ikatkov/metal-detector/fet-n-coil-test/thermal.jpg

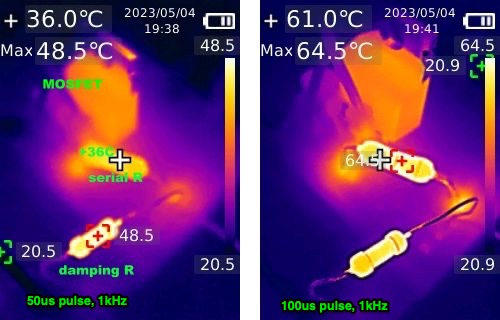
fet-n-coil-test/thermal.jpg
