ikatkov/metal-detector/2023-06-30/noise-canceling.jpg

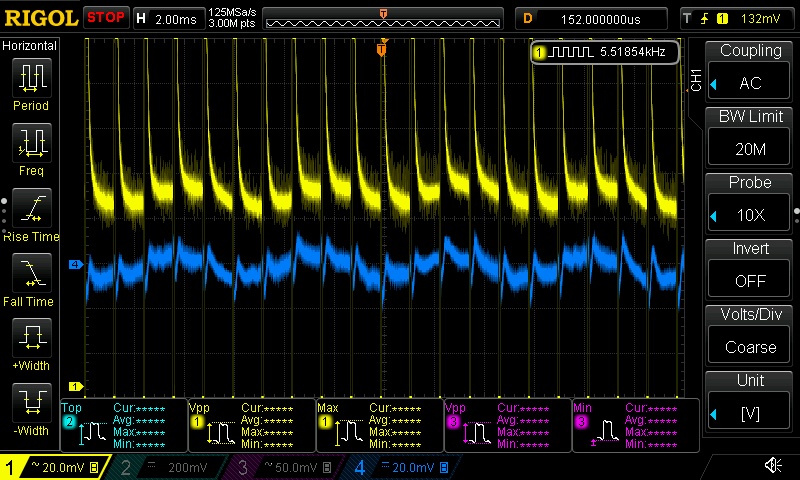
2023-06-30/noise-canceling.jpg
