ikatkov/metal-detector/2023-05-29-notes/coil-delay.jpg

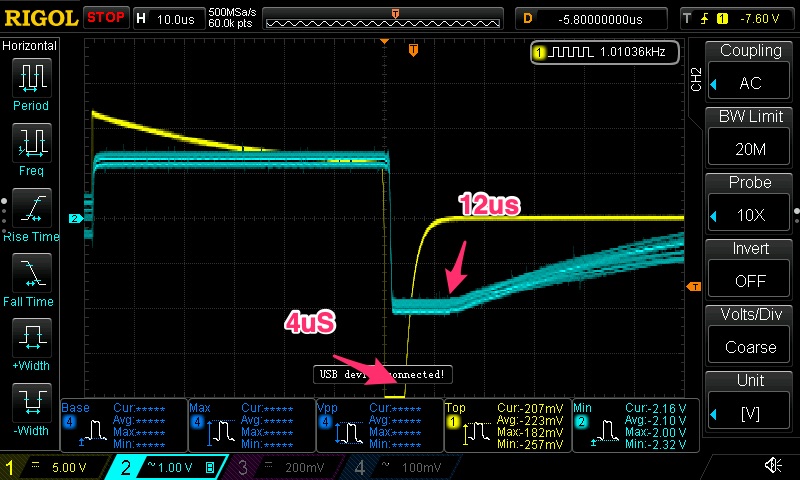
2023-05-29-notes/coil-delay.jpg
