ikatkov/metal-detector/2023-06-30/large-target.jpg

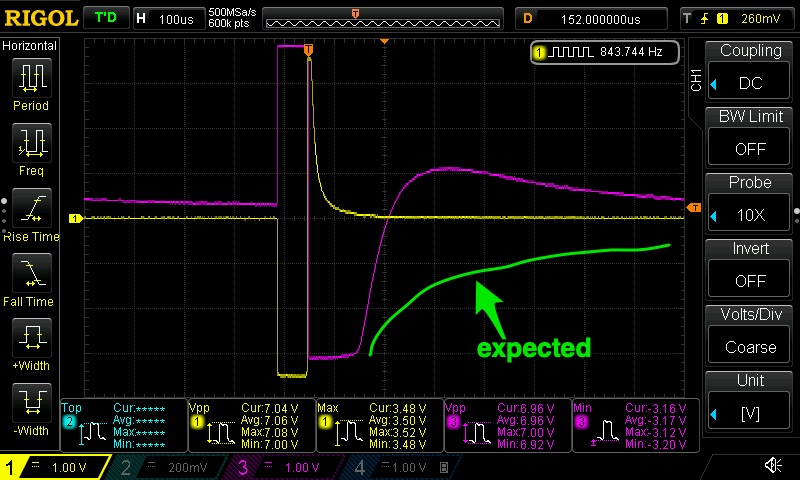
2023-06-30/large-target.jpg
