ikatkov/metal-detector/2023-06-30/no-target.jpg

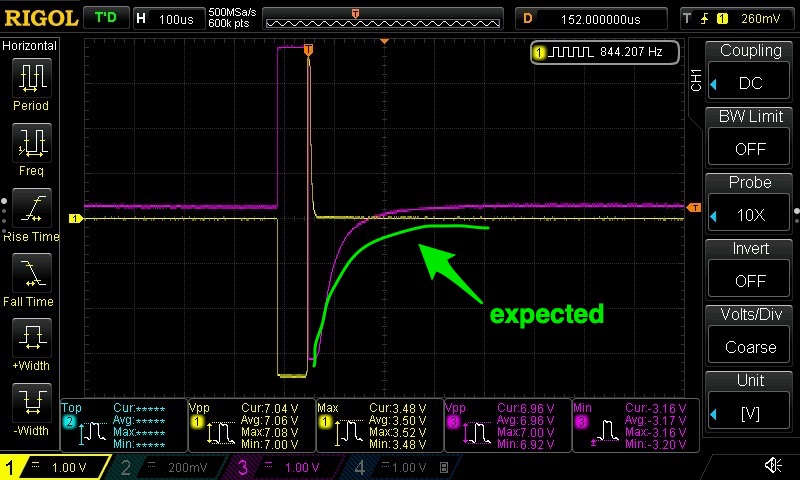
2023-06-30/no-target.jpg
