ikatkov/metal-detector/2023-07-02/pre-amp.jpg

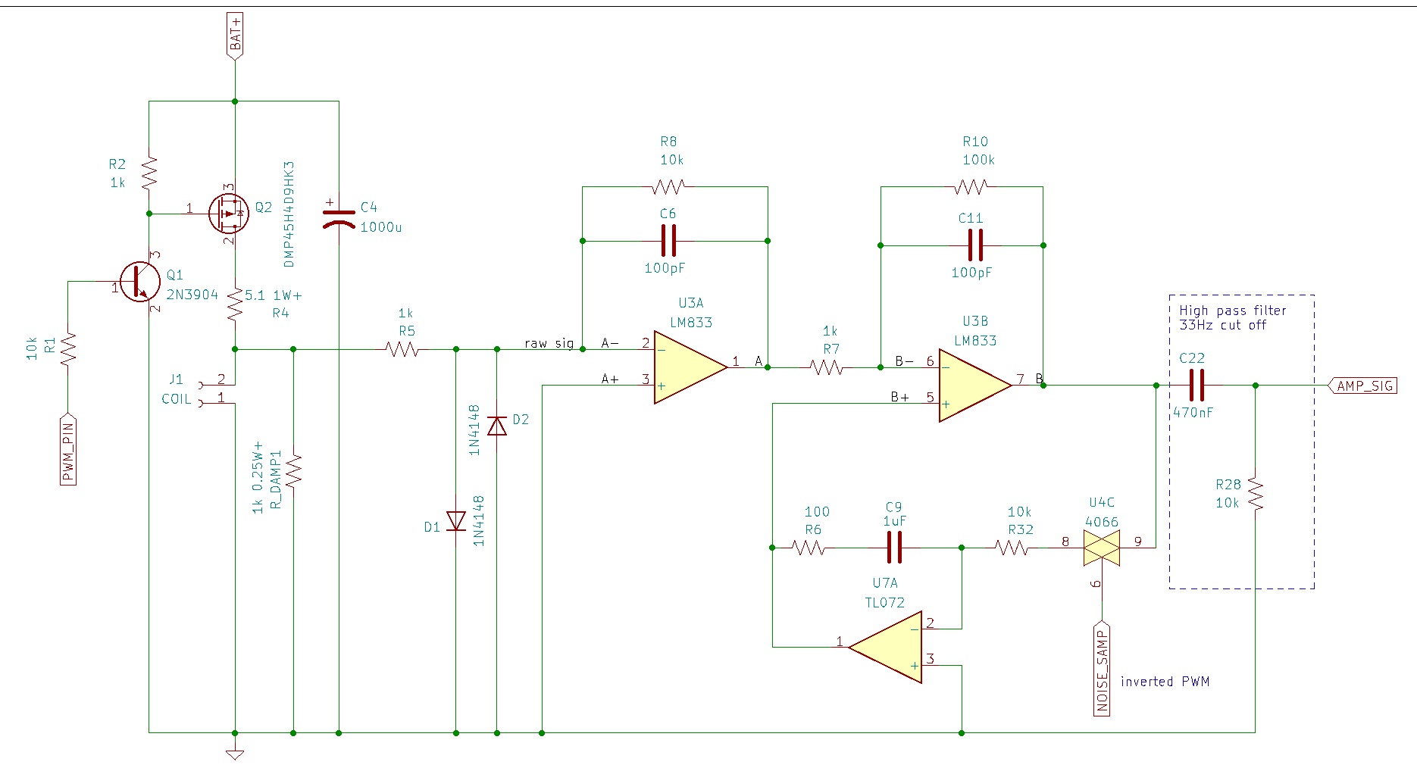
2023-07-02/pre-amp.jpg
