ikatkov/metal-detector/lt1054/lt1054-iv-curve-fitting.png

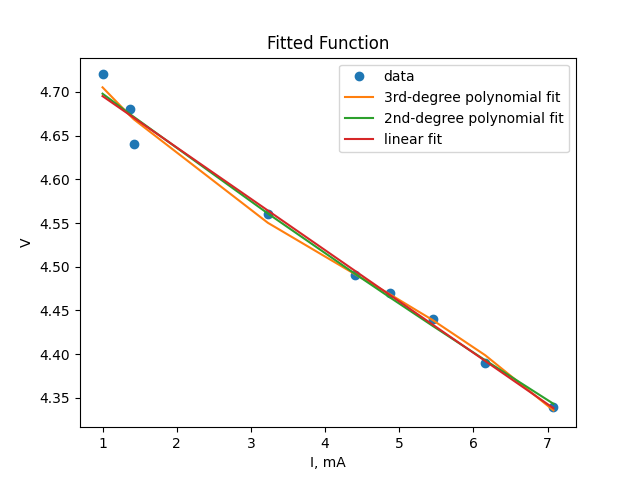
lt1054/lt1054-iv-curve-fitting.png
