ikatkov/metal-detector/schematic.pdf

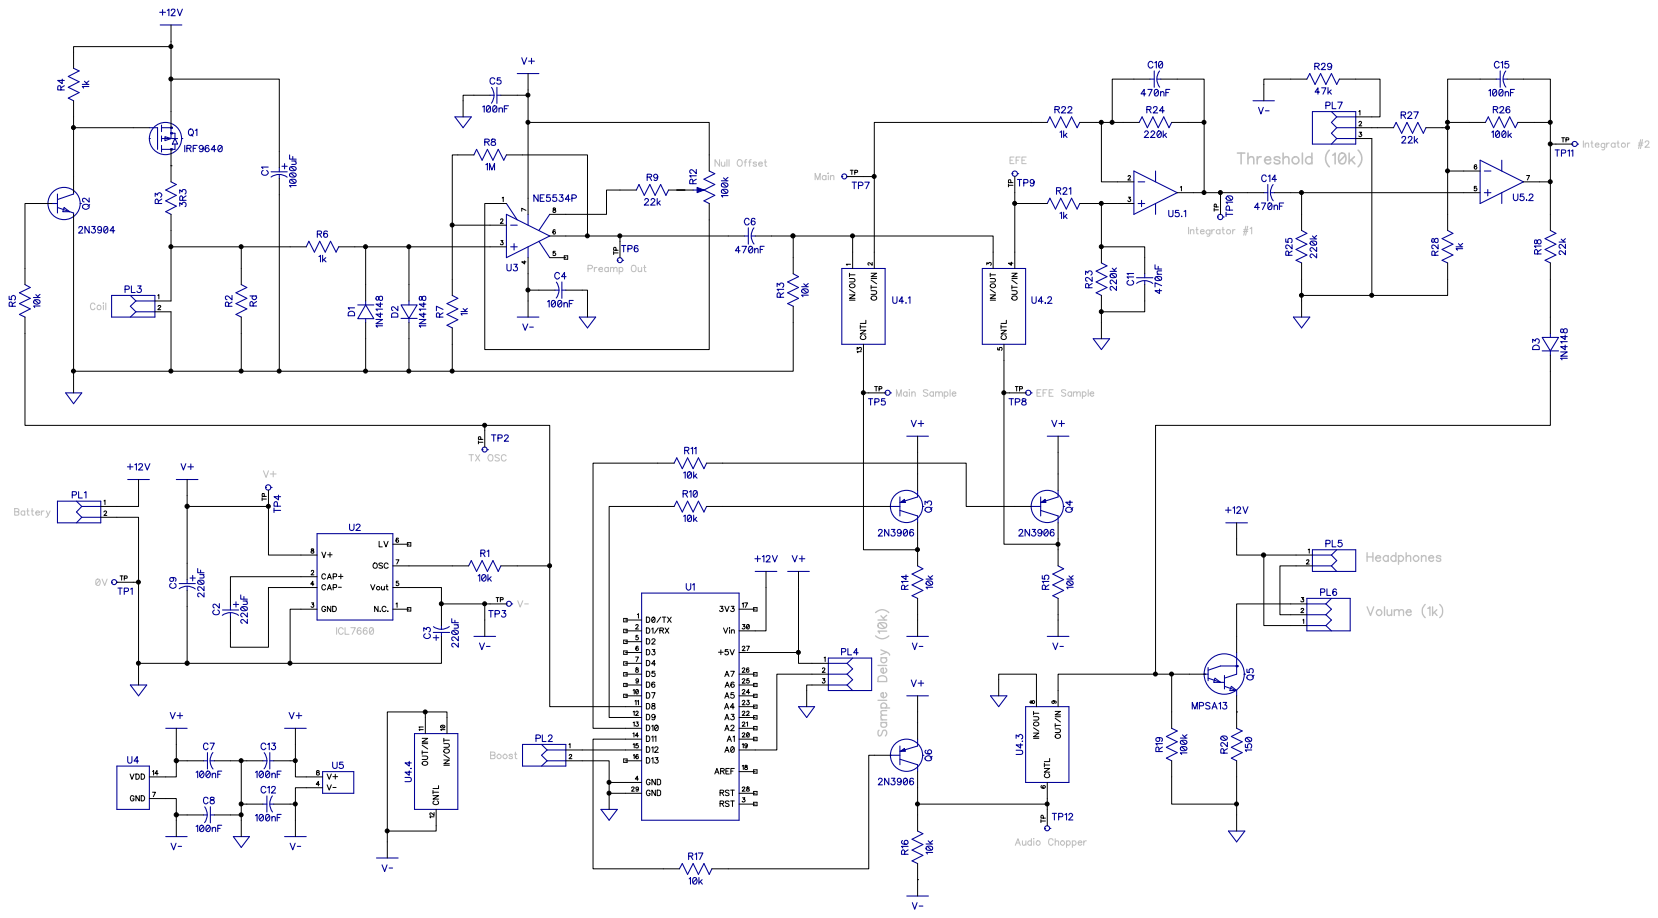
[picture p49: page 1]
