ikatkov/metal-detector/2023-06-30/full-schematic.pdf

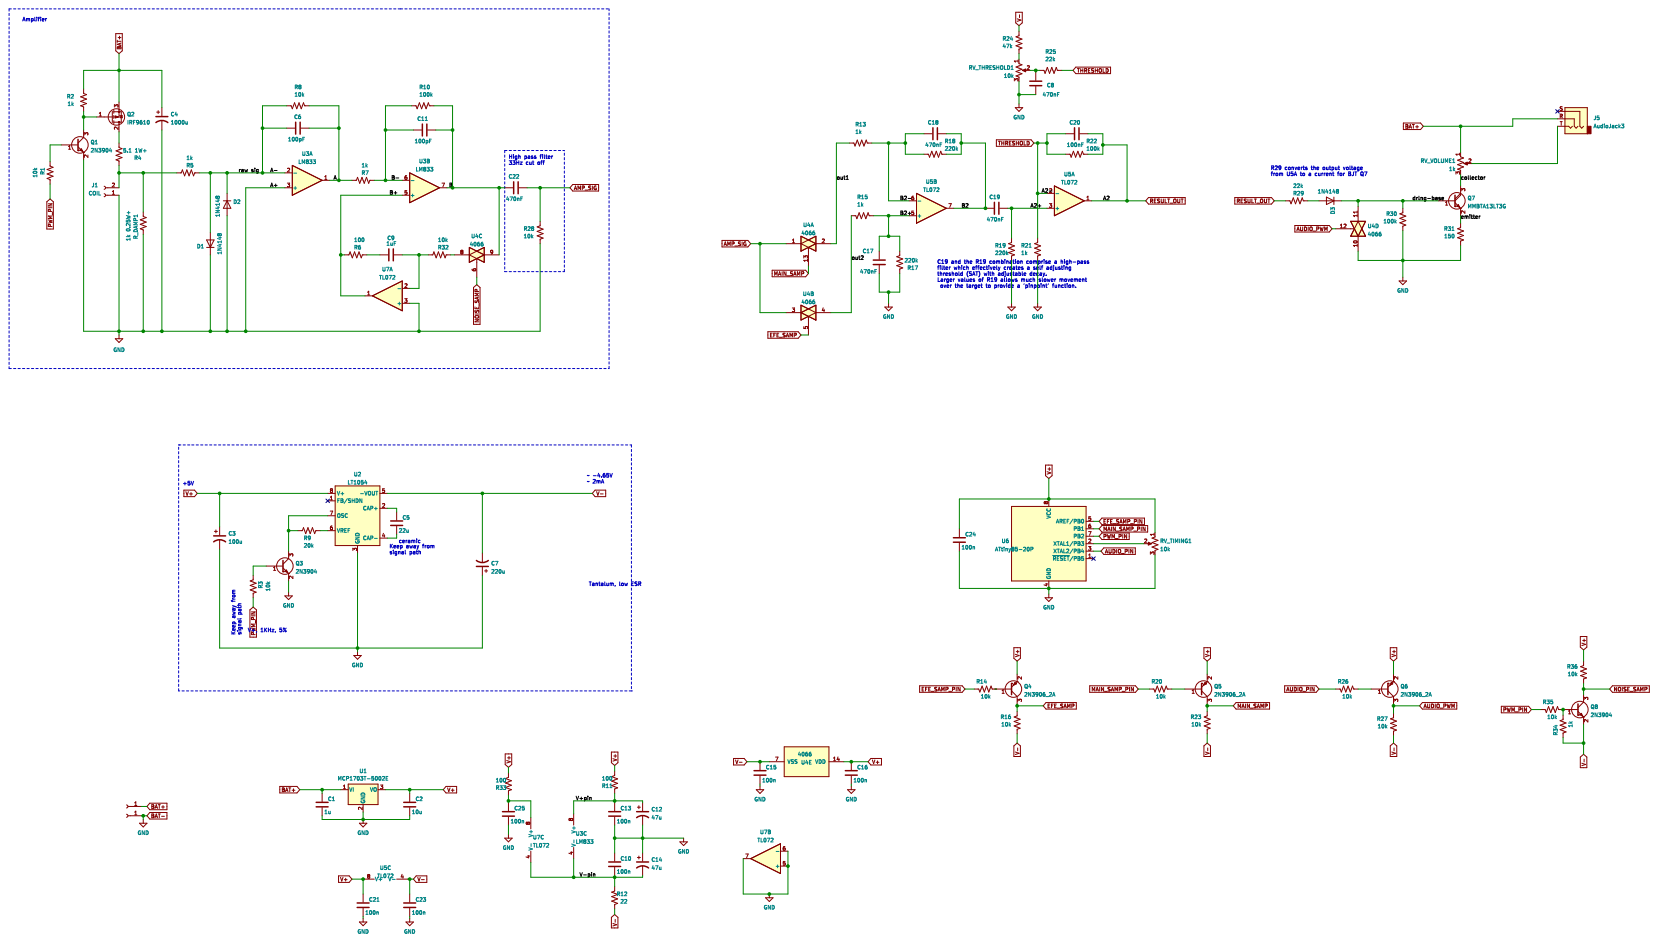
[picture p50: page 1]
