ikatkov/metal-detector/amp-board-dual-stage/Printing Print.pdf

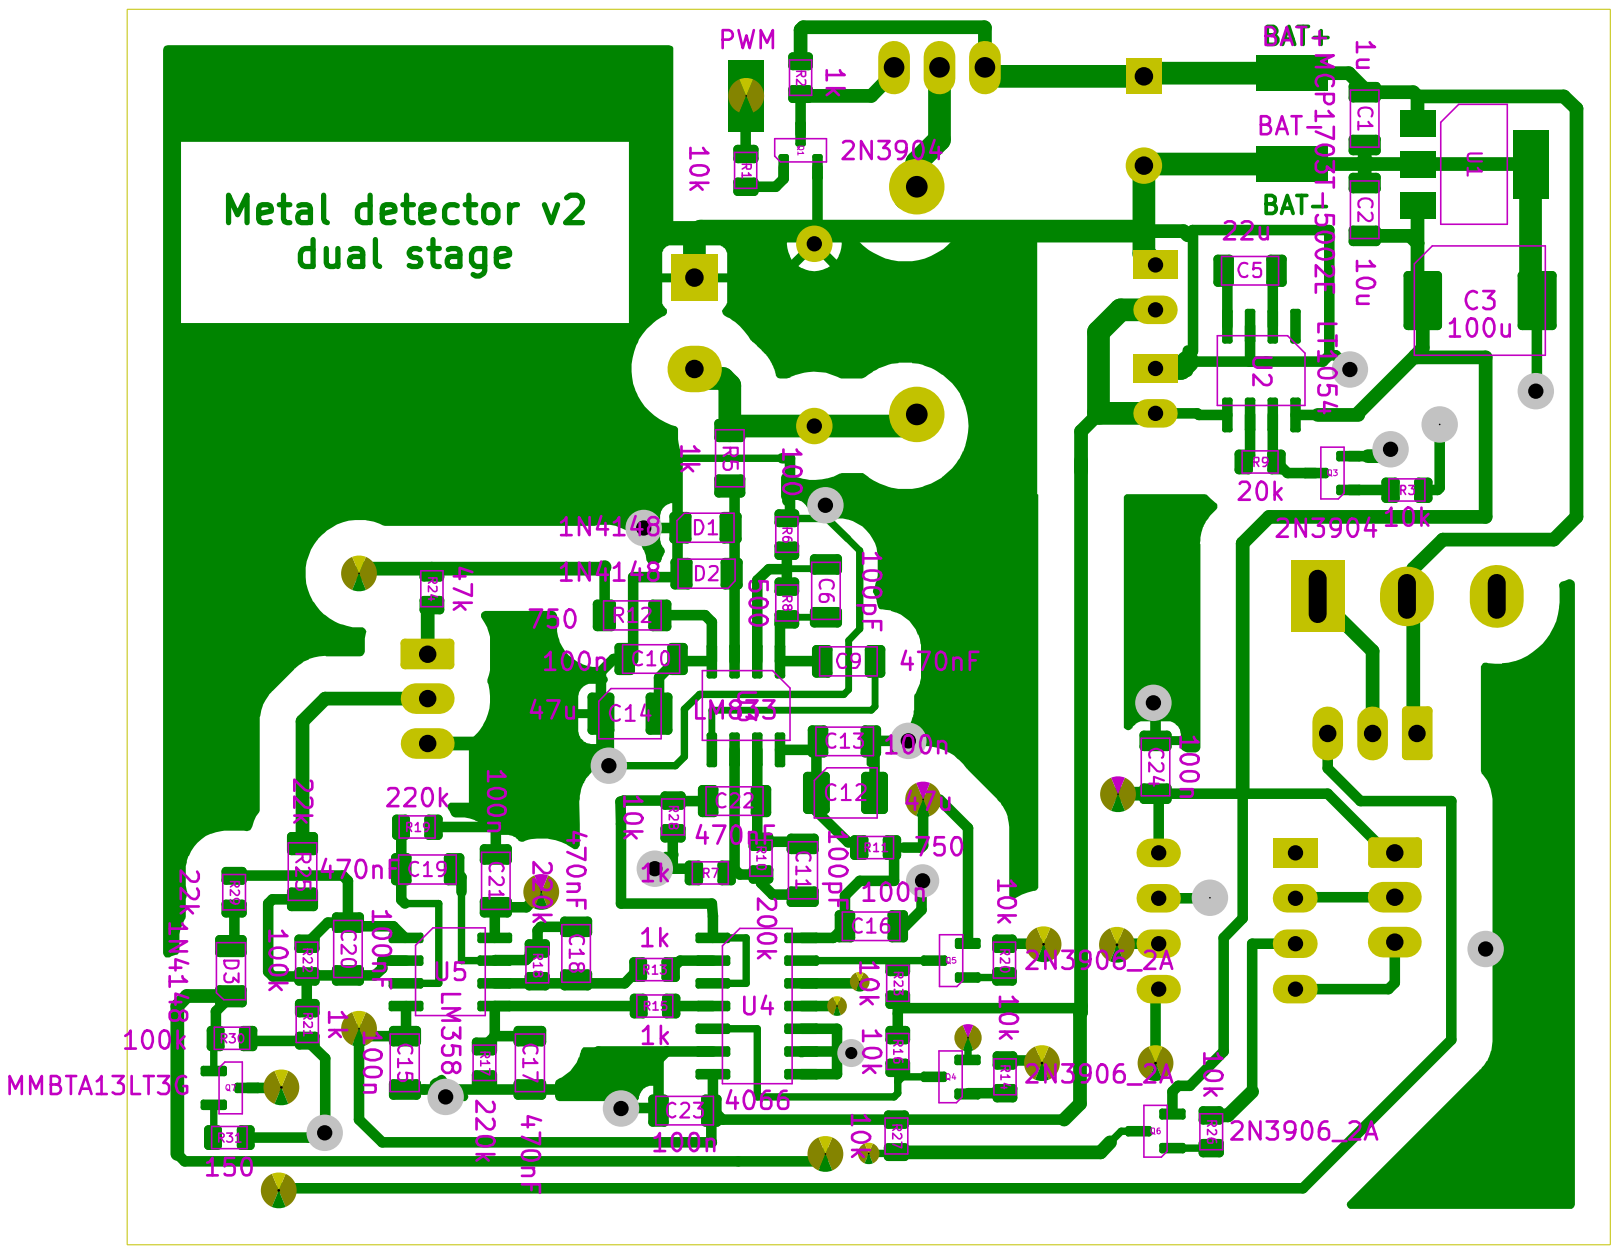
[picture p51: page 1]
