ikatkov/metal-detector/(list of files, drawings)

Other design files:
original-project-pi-detector/Arduino Nano PI - DipTrace files/Arduino_PI.dch
original-project-pi-detector/Arduino Nano PI - DipTrace files/Arduino_PI.dip
original-project-pi-detector/Battery Pack Charger - DipTrace files/Battery pack charger.dch
original-project-pi-detector/Battery Pack Charger - DipTrace files/Battery pack charger.dip
