ikatkov/metal-detector/amp-board-dual-stage/amp-board-dual-stage.kicad_pcb

## KiCad design amp-board-dual-stage/amp-board-dual-stage.kicad_pcb (2023-07-05)

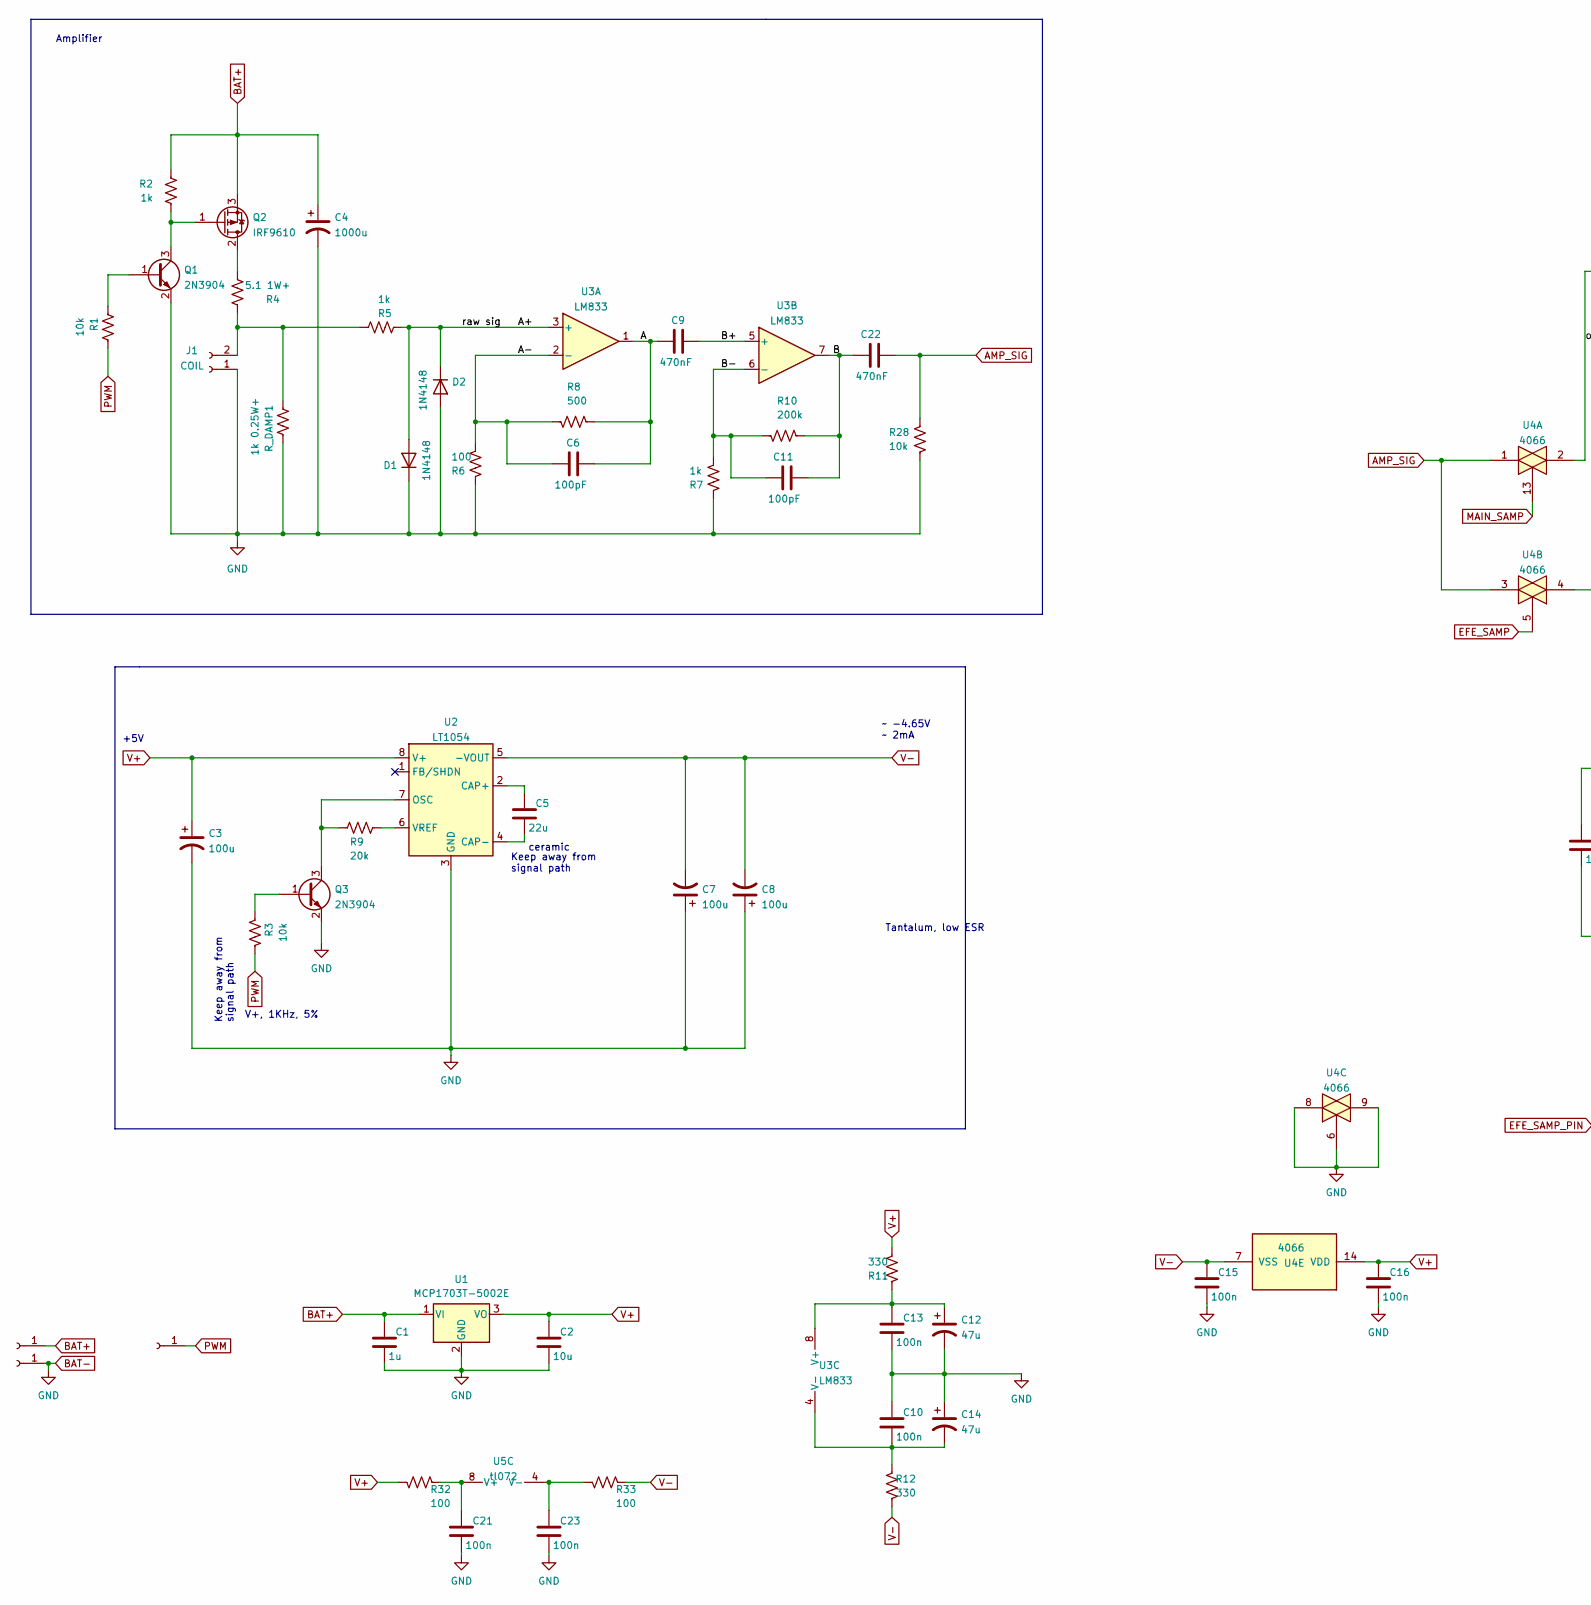
[picture p52: schematic amp-board-dual-stage.kicad_sch, part in row 1, column 1]

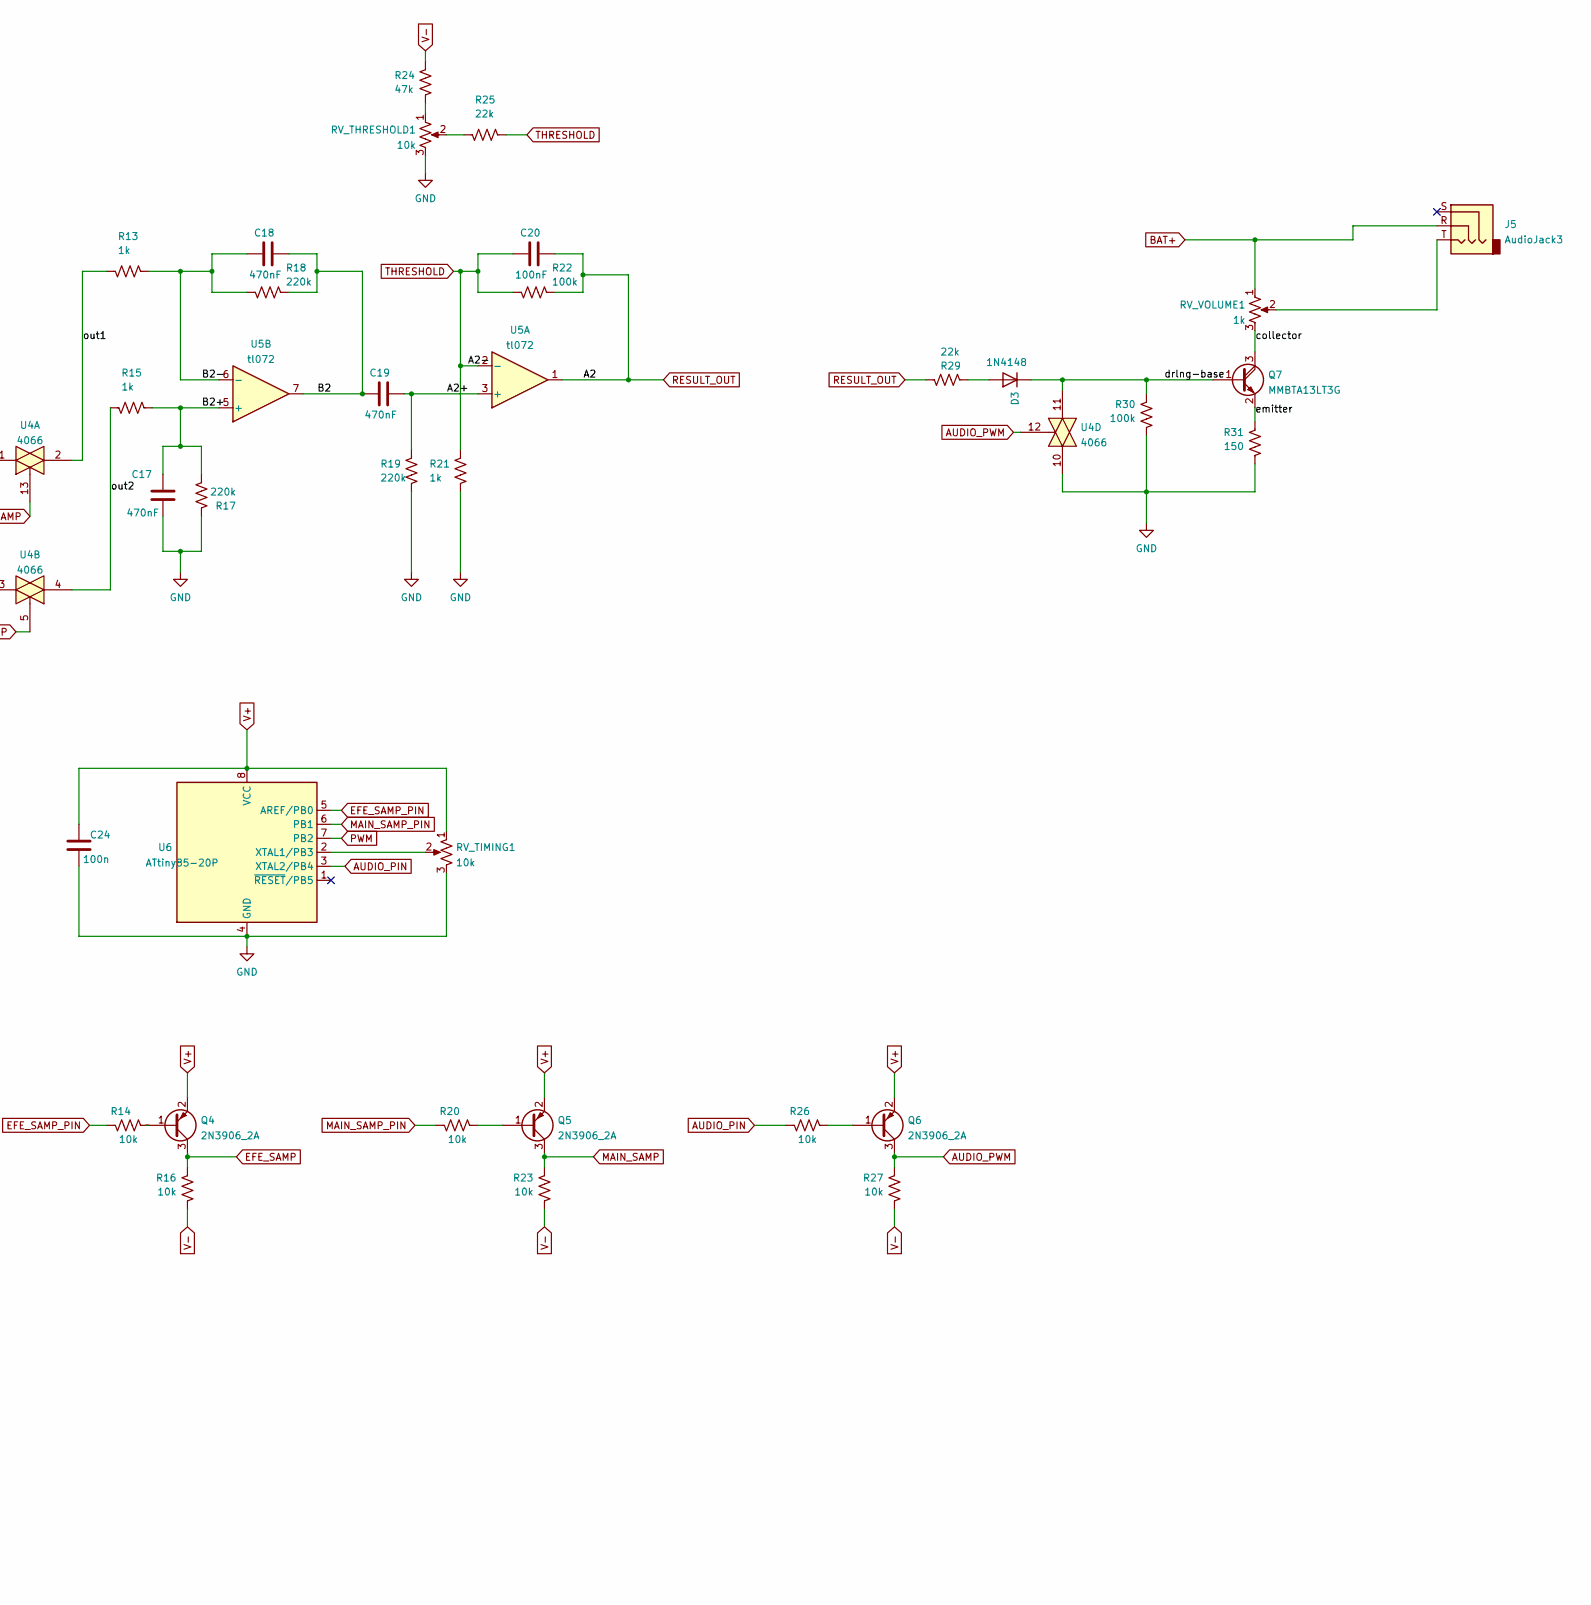
[picture p53: schematic amp-board-dual-stage.kicad_sch, part in row 1, column 2]

Parts:
C1: 1u; C_1206_3216Metric
C2: 10u; C_1206_3216Metric
C3: 100u; CP_EIA-7361-438_AVX-U_Pad2.18x3.30mm_HandSolder
C4: 1000u; CP_Radial_D10.0mm_P5.00mm
C5: 22u; C_1206_3216Metric
C6, C11: 100pF; C_1206_3216Metric
C7, C8: 100u; CP_Radial_D5.0mm_P2.50mm
C9, C17, C18, C19, C22: 470nF; C_1206_3216Metric
C10, C13, C15, C16, C21, C23, C24: 100n; C_1206_3216Metric
C12, C14: 47u; CP_EIA-3528-21_Kemet-B_Pad1.50x2.35mm_HandSolder
C20: 100nF; C_1206_3216Metric
D1, D2, D3: 1N4148; D_1206_3216Metric
J1: COIL; TerminalBlock_Phoenix_MKDS-1,5-2-5.08_1x02_P5.08mm_Horizont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
J2: BAT+; SolderWirePad_1x01_SMD_2x4mm
J3: BAT-; SolderWirePad_1x01_SMD_2x4mm
J4: PWM; SolderWirePad_1x01_SMD_2x4mm
J5: AudioJack3; audio-jack
Q1, Q3: 2N3904; SOT-23
Q2: IRF9610; TO-220-3_Vertical
Q4, Q5, Q6: 2N3906_2A; SOT-23
Q7: MMBTA13LT3G; SOT-23
R1, R3, R14, R16, R20, R23, R26, R27, R28: 10k; R_0805_2012Metric
R2, R7, R13, R15, R21: 1k; R_0805_2012Metric
R4: 5.1 1W+; R_Axial_DIN0411_L9.9mm_D3.6mm_P12.70mm_Horizontal
R5: 1k; R_1206_3216Metric_Pad1.30x1.75mm_HandSolder
R6, R32, R33: 100; R_0805_2012Metric
R8: 500; R_0805_2012Metric
R9: 20k; R_0805_2012Metric
R10: 200k; R_0805_2012Metric
R11: 330; R_0805_2012Metric
R12: 330; R_1206_3216Metric_Pad1.30x1.75mm_HandSolder
R17, R18, R19: 220k; R_0805_2012Metric
R22, R30: 100k; R_0805_2012Metric
R24: 47k; R_0805_2012Metric
R25: 22k; R_1206_3216Metric_Pad1.30x1.75mm_HandSolder
R29: 22k; R_0805_2012Metric
R31: 150; R_0805_2012Metric
RV_THRESHOLD1: 10k; JST_EH_B3B-EH-A_1x03_P2.50mm_Vertical
RV_TIMING1: 10k; JST_EH_B3B-EH-A_1x03_P2.50mm_Vertical
RV_VOLUME1: 1k; JST_EH_B3B-EH-A_1x03_P2.50mm_Vertical
R_DAMP1: 1k 0.25W+; R_Axial_DIN0207_L6.3mm_D2.5mm_P10.16mm_Horizontal
U1: MCP1703T-5002E; SOT-223-3_TabPin2
U2: LT1054; SOIC-8_3.9x4.9mm_P1.27mm
U3: LM833; SOIC-8_3.9x4.9mm_P1.27mm
U4: 4066; SO-14_3.9x8.65mm_P1.27mm
U5: tl072; SOIC-8_3.9x4.9mm_P1.27mm
U6: ATtiny85-20P; DIP-8_W7.62mm

Connections:
/A: C6.2, C9.1, R8.1, U3.1
/A2+: C19.2, R19.2, U5.3 (+)
/A+: D1.2 (A), D2.1 (K), R5.1, U3.3 (+)
/A-: C6.1, R6.2, R8.2, U3.2 (-)
/B: C11.2, C22.1, R10.1, U3.7
/B2: C18.2, C19.1, R18.1, U5.7
/B2+: C17.2, R15.1, R17.1, U5.5 (+)
/B2-: C18.1, R13.1, R18.2, U5.6 (-)
/B+: C9.2, U3.5 (+)
/B-: C11.1, R7.2, R10.2, U3.6 (-)
/collector: Q7.3 (C), RV_VOLUME1.3
/drlng-base: D3.1 (K), Q7.1 (B), R30.1, U4.11
/emitter: Q7.2 (E), R31.1
/out1: R13.2, U4.2
/out2: R15.2, U4.4
AMP_SIG: C22.2, R28.2, U4.1, U4.3
AUDIO_PIN: R26.1, U6.3 (XTAL2/PB4)
AUDIO_PWM: Q6.3 (C), R27.1, U4.12
BAT+: C1.1, C4.1, J2.1, J5.R, Q2.3 (S), R2.2, RV_VOLUME1.1, U1.1 (VI)
BAT-: C1.2, C2.2, C3.2, C4.2, C7.1, C8.1, C10.1, C12.2, C13.2, C14.1, C15.2, C16.2, C17.1, C21.2, C23.2, C24.2, D1.1 (K), D2.2 (A), J1.1, J3.1, Q1.2 (E), Q3.2 (E), R6.1, R7.1, R17.2, R19.1, R21.1, R28.1, R30.2, R31.2, RV_THRESHOLD1.3, RV_TIMING1.3, R_DAMP1.1, U1.2 (GND), U2.3 (GND), U4.6, U4.8, U4.9, U4.10, U6.4 (GND)
EFE_SAMP: Q4.3 (C), R16.1, U4.5
EFE_SAMP_PIN: R14.1, U6.5 (AREF/PB0)
MAIN_SAMP: Q5.3 (C), R23.1, U4.13
MAIN_SAMP_PIN: R20.1, U6.6 (PB1)
unnamed: C5.1, U2.2 (CAP+)
unnamed: C5.2, U2.4 (CAP-)
unnamed: C10.2, C14.2, R12.1, U3.4 (V-)
unnamed: C12.1, C13.1, R11.1, U3.8 (V+)
unnamed: D3.2 (A), R29.1
unnamed: J1.2, R4.2, R5.2, R_DAMP1.2
unnamed: J5.T, RV_VOLUME1.2
unnamed: Q1.1 (B), R1.2
unnamed: Q1.3 (C), Q2.1 (G), R2.1
unnamed: Q2.2 (D), R4.1
unnamed: Q3.1 (B), R3.2
unnamed: Q3.3 (C), R9.2, U2.7 (OSC)
unnamed: Q4.1 (B), R14.2
unnamed: Q5.1 (B), R20.2
unnamed: Q6.1 (B), R26.2
unnamed: R9.1, U2.6 (VREF)
unnamed: R24.1, RV_THRESHOLD1.1
unnamed: R25.2, RV_THRESHOLD1.2
unnamed: RV_TIMING1.2, U6.2 (XTAL1/PB3)
PWM: J4.1, R1.1, R3.1, U6.7 (PB2)
RESULT_OUT: C20.2, R22.1, R29.2, U5.1
THRESHOLD: C20.1, R21.2, R22.2, R25.1, U5.2 (-)

Notes on the sheet:
V+, 1KHz, 5%
Amplifier
Keep away from signal path
ceramic
Tantalum, low ESR
~ -4.65V ~ 2mA
+5V

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
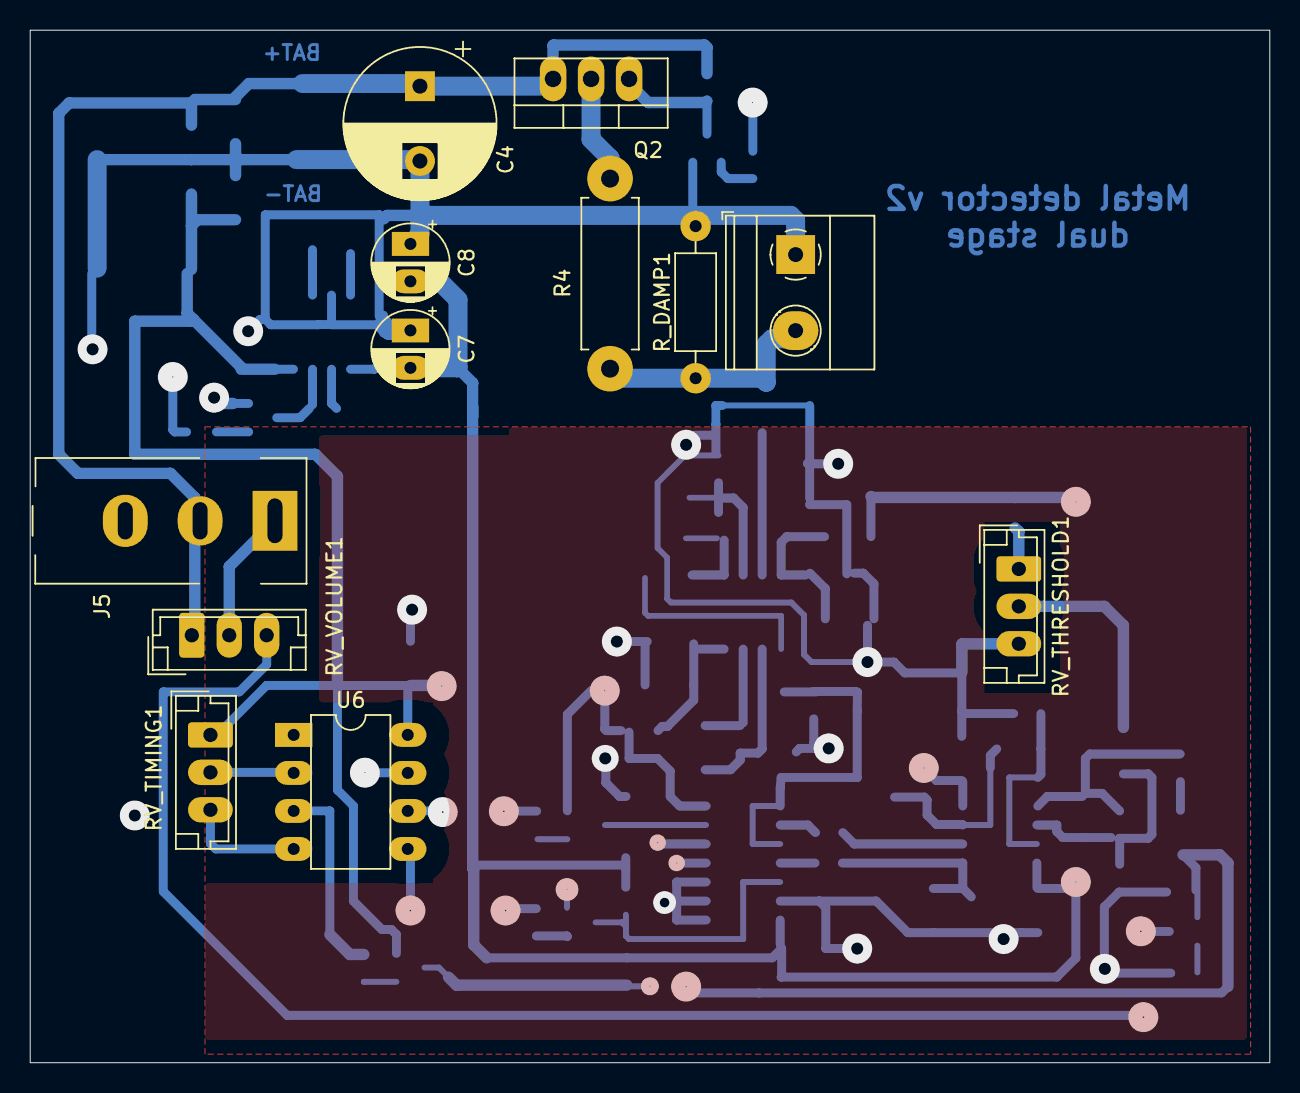
[picture p54: board amp-board-dual-stage.kicad_pcb from above]

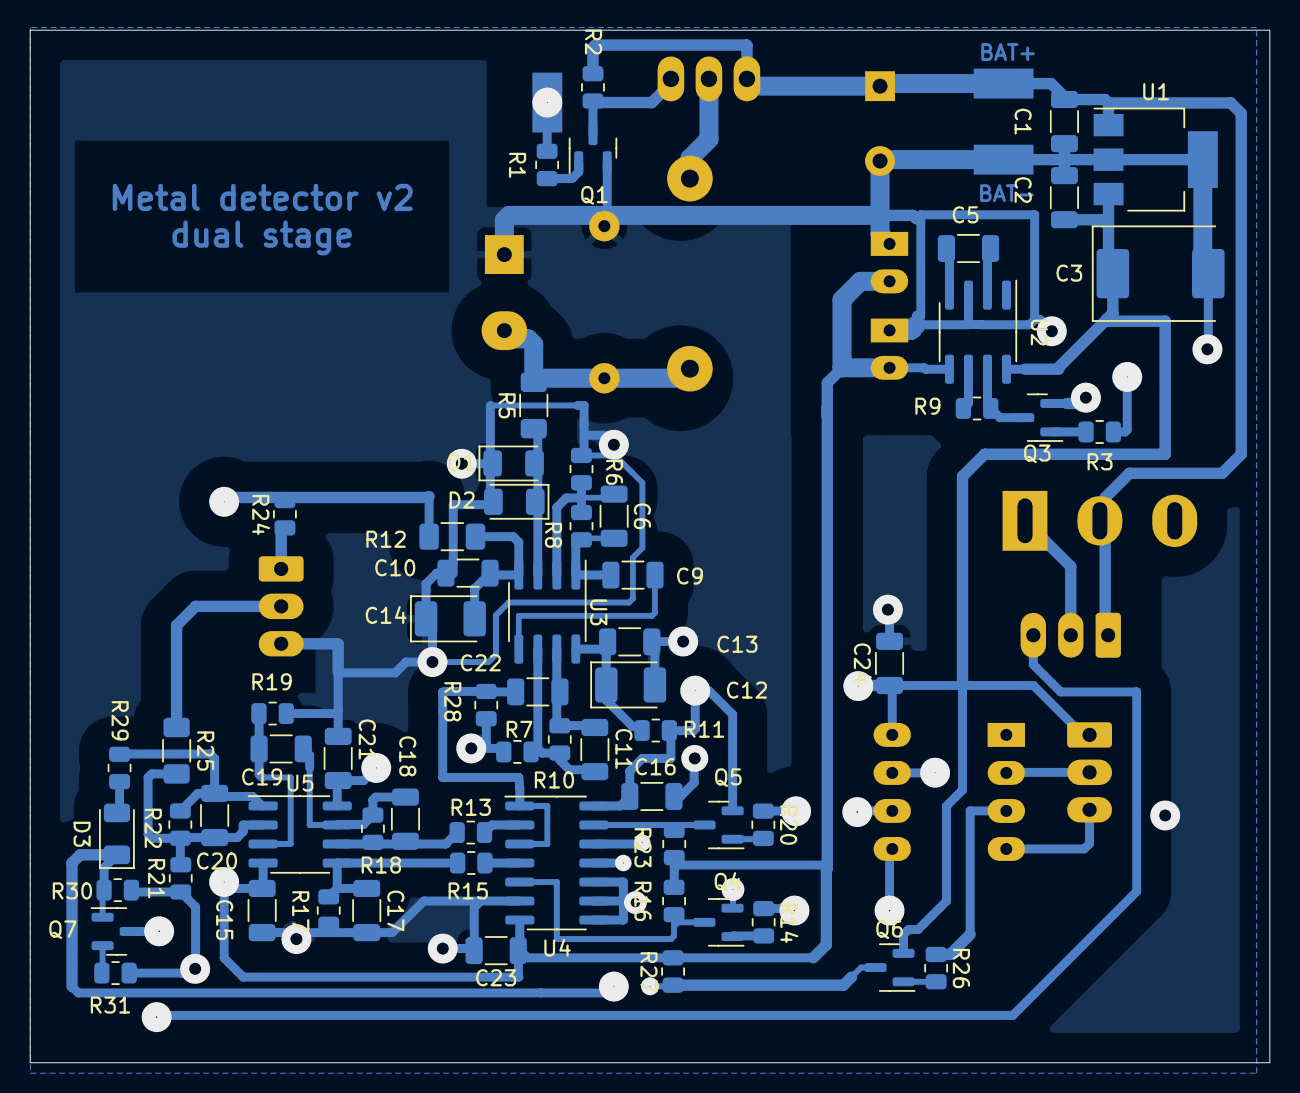
[picture p55: board amp-board-dual-stage.kicad_pcb from below]

Board: 4 copper layers, 82.8 x 69.0 mm, 80 parts (68 on the bottom side), 48 nets.
