ikatkov/metal-detector/amp-board/amp-board.kicad_pcb

## KiCad design amp-board/amp-board.kicad_pcb (2023-07-05)

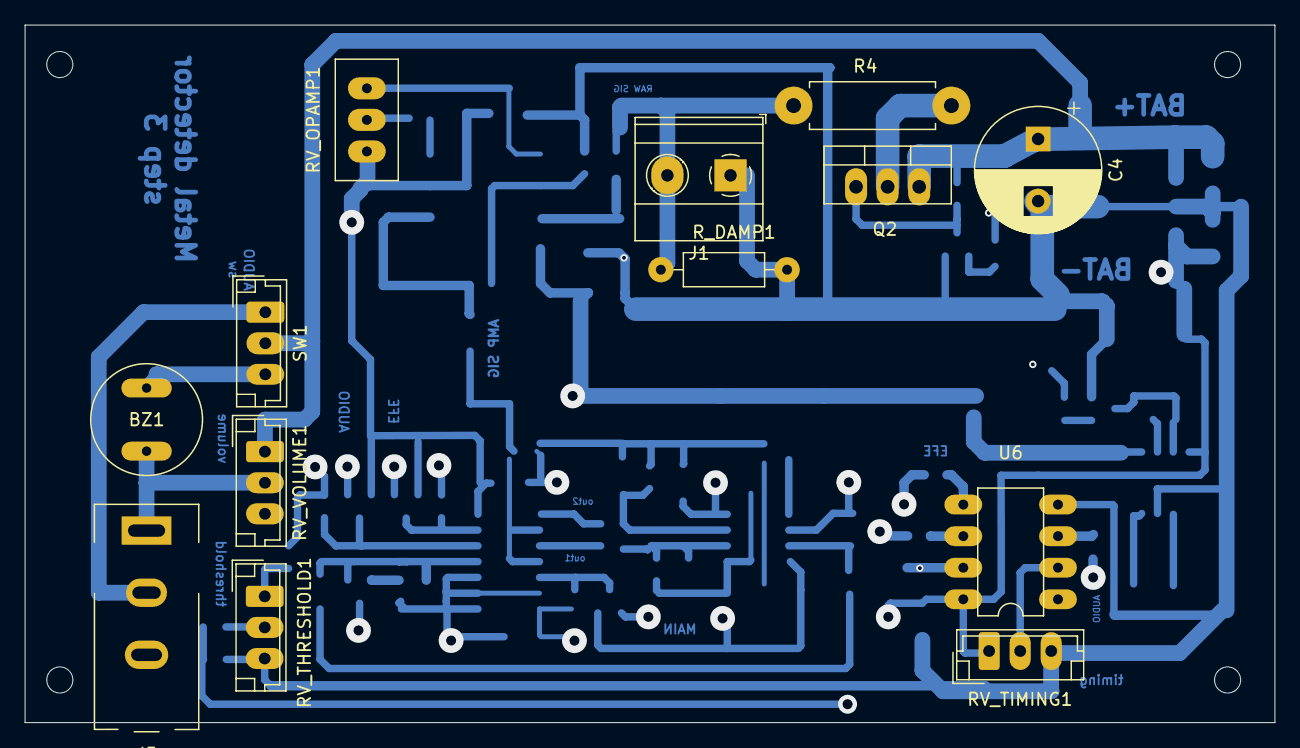
[picture p56: board amp-board.kicad_pcb from above]

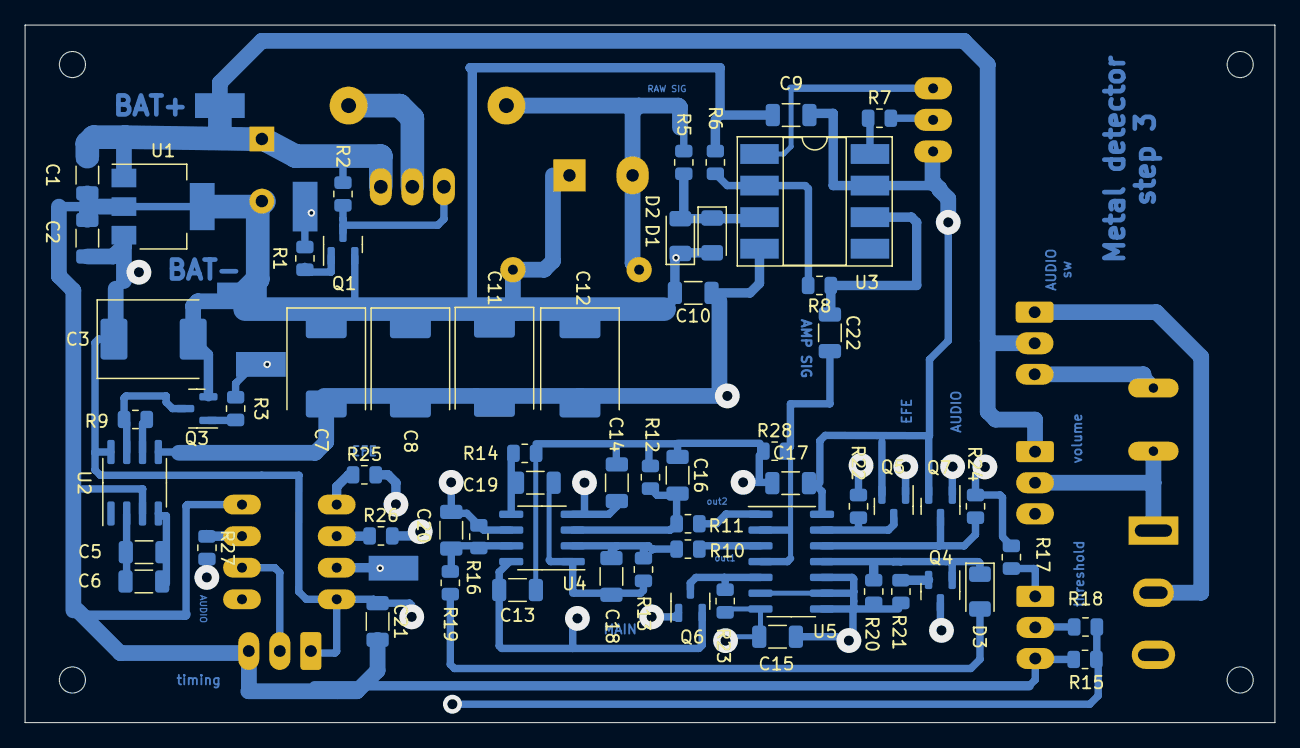
[picture p57: board amp-board.kicad_pcb from below]

Board: 4 copper layers, 100.6 x 56.1 mm, 78 parts (65 on the bottom side), 48 nets.

Parts:
BZ1: Buzzer; Buzzer-GT-0905A
C1: 1u; C_1206_3216Metric
C2: 10u; C_1206_3216Metric
C3, C7, C8, C11, C12: 100u; CP_EIA-7361-438_AVX-U_Pad2.18x3.30mm_HandSolder
C4: 1000u; CP_Radial_D10.0mm_P5.00mm
C5, C6: 22u; C_1206_3216Metric
C9, C10, C13, C14, C15, C17, C21: 100n; C_1206_3216Metric
C16, C18, C19, C22: 470nF; C_1206_3216Metric
C20: 100nF; C_1206_3216Metric
D1, D2, D3: 1N4148; D_1206_3216Metric
J1: COIL; TerminalBlock_Phoenix_MKDS-1,5-2-5.08_1x02_P5.08mm_Horizont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
J2: BAT+; SolderWirePad_1x01_SMD_2x4mm
J3: BAT-; SolderWirePad_1x01_SMD_2x4mm
J4: PWM; SolderWirePad_1x01_SMD_2x4mm
J5: AudioJack3; audio-jack
Q1, Q3: 2N3904; SOT-23
Q2: IRF9610; TO-220-3_Vertical
Q4: MMBTA13LT3G; SOT-23
Q5, Q6, Q7: 2N3906_2A; SOT-23
R1, R3, R22, R23, R24, R25, R26, R27: 10k; R_0805_2012Metric
R2, R5, R6, R10, R11, R15, R28: 1k; R_0805_2012Metric
R4: 5.1 1W+; R_Axial_DIN0411_L9.9mm_D3.6mm_P12.70mm_Horizontal
R7, R18, R19: 22k; R_0805_2012Metric
R8: 1M; R_0805_2012Metric
R9: 20k; R_0805_2012Metric
R12, R13, R14: 220k; R_0805_2012Metric
R16, R20: 100k; R_0805_2012Metric
R17: 47k; R_0805_2012Metric
R21: 150; R_0805_2012Metric
RV_OPAMP1: 100k; Potentiometer_Bourns_3296W_Vertical
RV_THRESHOLD1: 10k; JST_EH_B3B-EH-A_1x03_P2.50mm_Vertical
RV_TIMING1: 10k; JST_EH_B3B-EH-A_1x03_P2.50mm_Vertical
RV_VOLUME1: 1k; JST_EH_B3B-EH-A_1x03_P2.50mm_Vertical
R_DAMP1: 1k 0.25W+; R_Axial_DIN0207_L6.3mm_D2.5mm_P10.16mm_Horizontal
SW1: SW_SPDT; JST_EH_B3B-EH-A_1x03_P2.50mm_Vertical
U1: MCP1703T-5002E; SOT-223-3_TabPin2
U2: LT1054; SOIC-8_3.9x4.9mm_P1.27mm
U3: NE5534; DIP-8_W8.89mm_SMDSocket_LongPads
U4: LM358; SOIC-8_3.9x4.9mm_P1.27mm
U5: 4066; SO-14_3.9x8.65mm_P1.27mm
U6: ATtiny85-20P; DIP-8_W7.62mm

Connections:
/collector: Q4.3 (C), RV_VOLUME1.3
/drlng-base: D3.1 (K), Q4.1 (B), R20.1, U5.11
/emitter: Q4.2 (E), R21.1
/out1: R10.2, U5.3
/out2: R11.2, U5.1
/raw sig: D1.2 (A), D2.1 (K), R5.1, U3.3 (+)
/stg1: C18.2, C19.1, R13.1, U4.1
AMP_SIG: C22.2, R28.2, U5.2, U5.4
AUDIO_PIN: R27.1, U6.3 (XTAL2/PB4)
AUDIO_PWM: Q7.3 (C), R24.1, U5.12
BAT+: C1.1, C4.1, J2.1, Q2.3 (S), R2.2, RV_VOLUME1.1, SW1.2 (B), U1.1 (VI)
BAT-: C1.2, C2.2, C3.2, C4.2, C7.1, C8.1, C9.2, C10.2, C11.1, C12.1, C13.2, C14.2, C15.2, C16.1, C17.2, C21.2, D1.1 (K), D2.2 (A), J1.1, J3.1, Q1.2 (E), Q3.2 (E), R6.1, R12.2, R14.1, R15.1, R20.2, R21.2, R28.1, RV_THRESHOLD1.3, RV_TIMING1.3, R_DAMP1.1, U1.2 (GND), U2.3 (GND), U5.6, U5.8, U5.9, U5.10, U6.4 (GND)
EFE_SAMP: Q5.3 (C), R22.1, U5.13
EFE_SAMP_PIN: R25.1, U6.5 (AREF/PB0)
MAIN_SAMP: Q6.3 (C), R23.1, U5.5
MAIN_SAMP_PIN: R26.1, U6.6 (PB1)
unnamed: BZ1.1 (-), SW1.3 (C)
unnamed: BZ1.2 (+), J5.T, RV_VOLUME1.2
unnamed: C5.1, C6.1, U2.2 (CAP+)
unnamed: C5.2, C6.2, U2.4 (CAP-)
unnamed: C16.2, R11.1, R12.1, U4.3 (+)
unnamed: C18.1, R10.1, R13.2, U4.2 (-)
unnamed: C19.2, R14.2, U4.5 (+)
unnamed: D3.2 (A), R19.1
unnamed: J1.2, R4.2, R5.2, R_DAMP1.2
unnamed: J5.R, SW1.1 (A)
unnamed: Q1.1 (B), R1.2
unnamed: Q1.3 (C), Q2.1 (G), R2.1
unnamed: Q2.2 (D), R4.1
unnamed: Q3.1 (B), R3.2
unnamed: Q3.3 (C), R9.2, U2.7 (OSC)
unnamed: Q5.1 (B), R25.2
unnamed: Q6.1 (B), R26.2
unnamed: Q7.1 (B), R27.2
unnamed: R6.2, R8.2, U3.2 (-)
unnamed: R7.1, U3.8 (C/B)
unnamed: R7.2, RV_OPAMP1.2
unnamed: C22.1, R8.1, U3.6
unnamed: R9.1, U2.6 (VREF)
unnamed: R17.1, RV_THRESHOLD1.1
unnamed: R18.2, RV_THRESHOLD1.2
unnamed: RV_OPAMP1.3, U3.1 (BAL)
unnamed: RV_TIMING1.2, U6.2 (XTAL1/PB3)
PWM: J4.1, R1.1, R3.1, U6.7 (PB2)
RESULT_OUT: C20.2, R16.1, R19.2, U4.7
THRESHOLD: C20.1, R15.2, R16.2, R18.1, U4.6 (-)
V+: C2.1, C3.1, C9.1, C13.1, C17.1, C21.1, Q5.2 (E), Q6.2 (E), Q7.2 (E), RV_OPAMP1.1, RV_TIMING1.1, U1.3 (VO), U2.8 (V+), U3.7 (V+), U4.8 (V+), U5.14 (VDD), U6.8 (VCC)
V-: C7.2, C8.2, C10.1, C11.2, C12.2, C14.1, C15.1, R17.2, R22.2, R23.2, R24.2, U2.5 (-VOUT), U3.4 (V-), U4.4 (V-), U5.7 (VSS)
