ikatkov/metal-detector/negative-voltage-board/negative-voltage-board.kicad_pcb

## KiCad design negative-voltage-board/negative-voltage-board.kicad_pcb (2023-04-22)

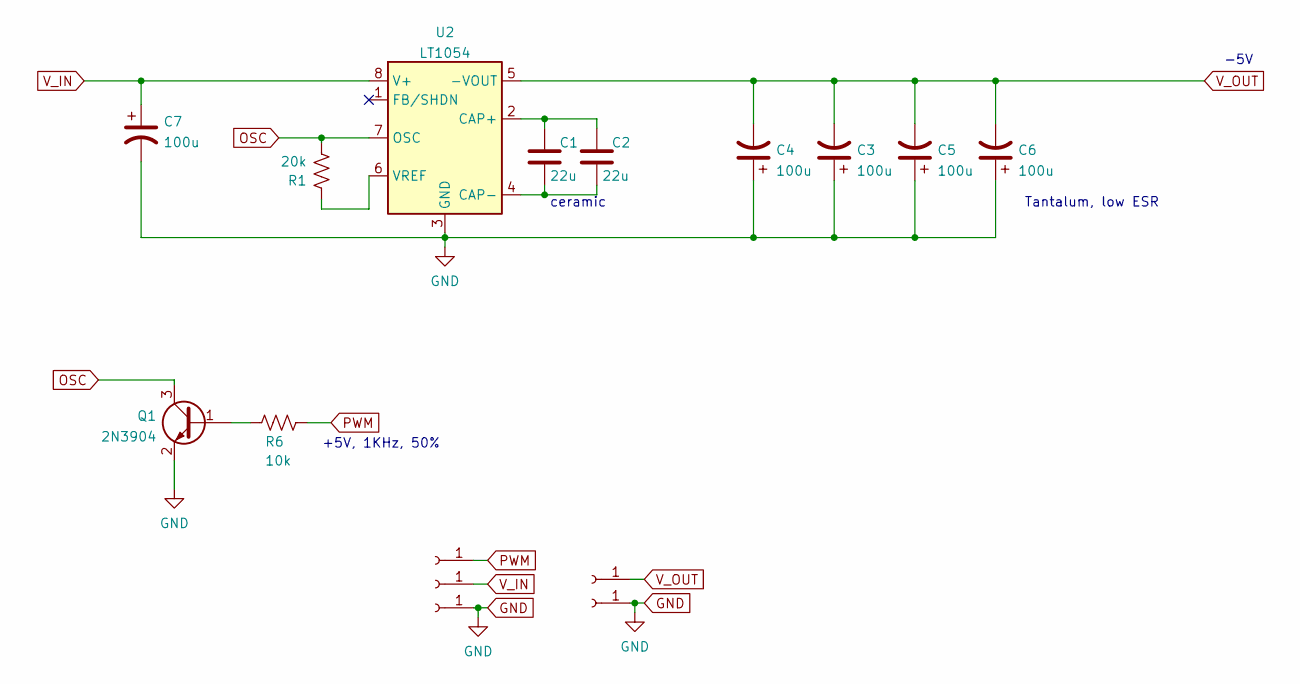
[picture p58: schematic negative-voltage-board.kicad_sch]

Parts:
C1, C2: 22u; C_1206_3216Metric
C3, C4, C5, C6, C7: 100u; CP_EIA-7361-438_AVX-U_Pad2.18x3.30mm_HandSolder
J1: Vin; PinSocket_1x01_P2.54mm_Vertical
J2, J4: GND; PinSocket_1x01_P2.54mm_Vertical
J3: Vout; PinSocket_1x01_P2.54mm_Vertical
J5: PWM; PinSocket_1x01_P2.54mm_Vertical
Q1: 2N3904; SOT-23
R1: 20k; R_0805_2012Metric
R6: 10k; R_0805_2012Metric
U2: LT1054; DIP-8_W8.89mm_SMDSocket_LongPads

Connections:
GND: C3.1, C4.1, C5.1, C6.1, C7.2, J2.1, J4.1, Q1.2 (E), U2.3 (GND)
unnamed: C1.1, C2.1, U2.2 (CAP+)
unnamed: C1.2, C2.2, U2.4 (CAP-)
unnamed: Q1.1 (B), R6.2
unnamed: R1.1, U2.6 (VREF)
OSC: Q1.3 (C), R1.2, U2.7 (OSC)
PWM: J5.1, R6.1
V_IN: C7.1, J1.1, U2.8 (V+)
V_OUT: C3.2, C4.2, C5.2, C6.2, J3.1, U2.5 (-VOUT)

Notes on the sheet:
ceramic
Tantalum, low ESR
-5V
+5V, 1KHz, 50%

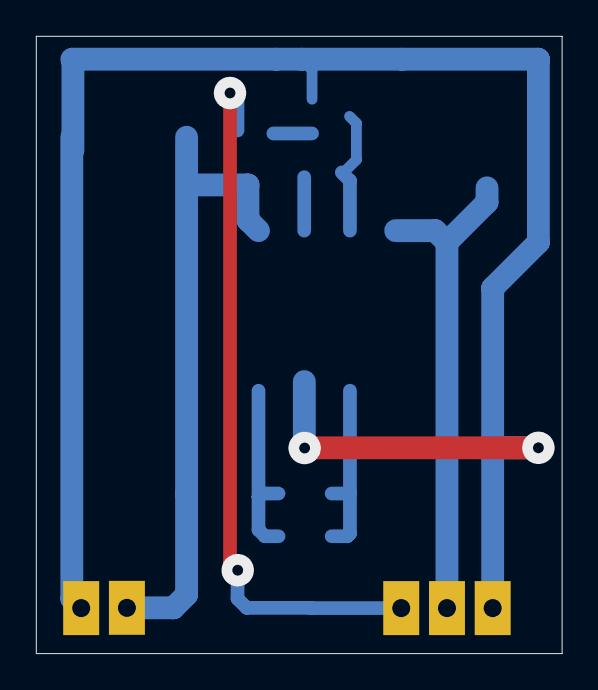
[picture p59: board negative-voltage-board.kicad_pcb from above]

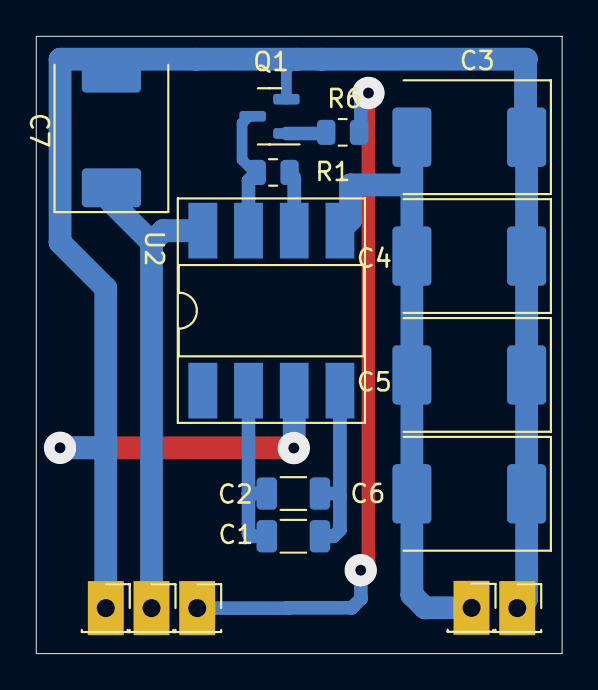
[picture p60: board negative-voltage-board.kicad_pcb from below]

Board: 4 copper layers, 29.2 x 34.3 mm, 16 parts (16 on the bottom side), 9 nets.
