ikatkov/metal-detector/(commit log)

2023-04-22 add main and amp boards
    [amp-board.kicad_pcb, amp-board.kicad_sch, amp-board.sch, main-board.kicad_pcb, main-board.kicad_sch, main-board.sch]
2023-04-26 step2 layout
    [amp-board.kicad_pcb, amp-board.kicad_sch]
